loptienm/Door_Control_PCB/README.md

Front Door Controller
=====================

This is a Front Door Dead Bolt Controller.  This board integrates a Particle Core, a motor controller, and the Lockitron Mechanical Assembly from Sparkfun to lock and unlock the deadbolt on an external door over the internet.
