loptienm/Door_Control_PCB/FrontDoorController.brd

## EAGLE design FrontDoorController.brd (2015-07-19)

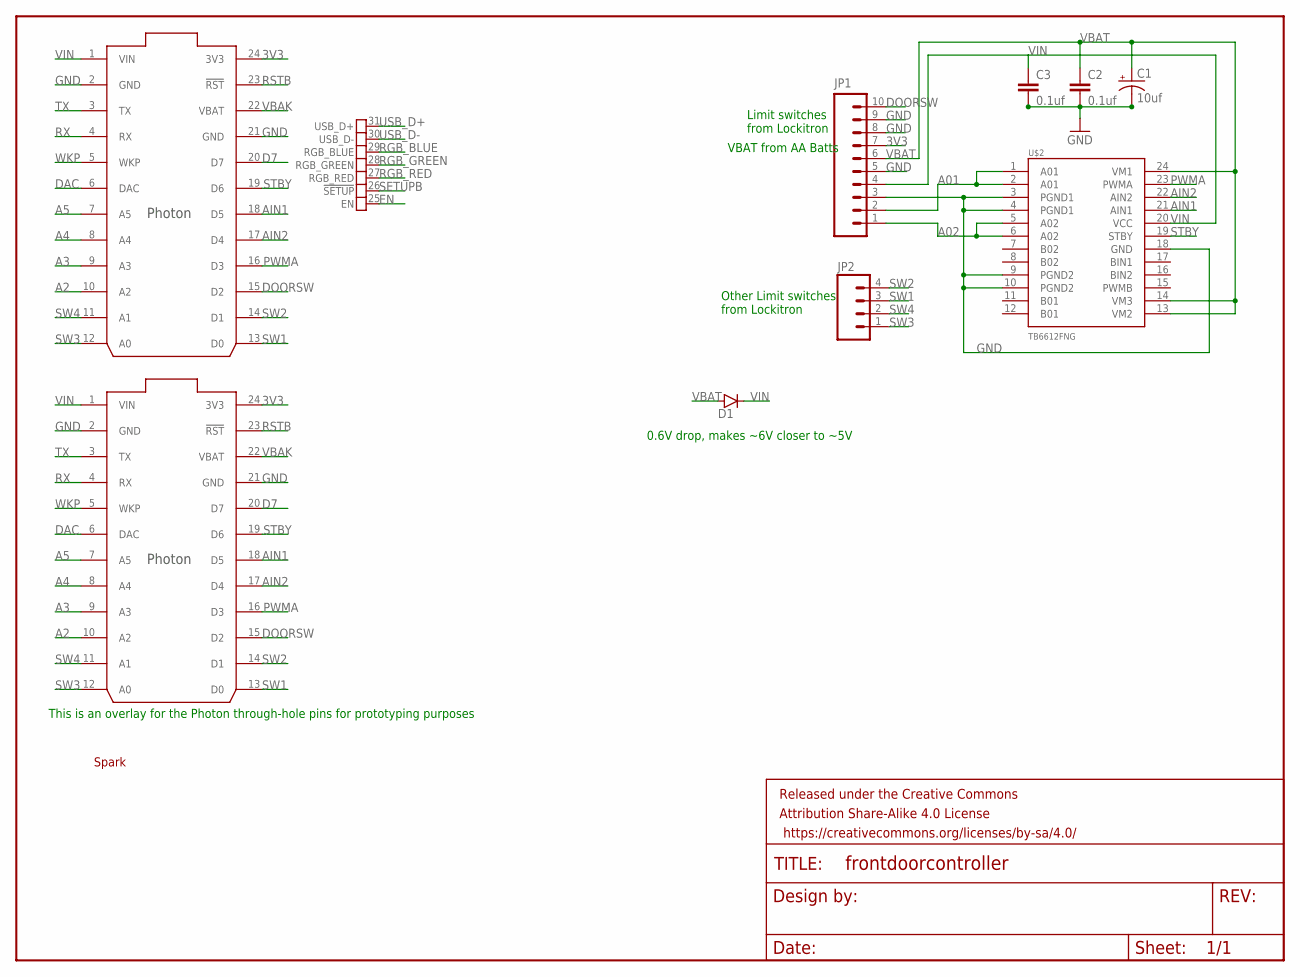
[picture p1: schematic FrontDoorController.sch]

Parts:
C1: 10uf; EIA3528
C2, C3: 0.1uf; 0402-CAP
D1: DIODEPTH; DIODE-1N4001
FRAME1: FRAME-LETTER; CREATIVE_COMMONS
JP1: M10LOCK; 1X10_LOCK
JP2: M04LOCK; 1X04_LOCK
PHOTON: PHOTON_SMD
U$1: SPARK_LOGOLARGE; SPARK_LOGO
U$2: TB6612FNG; SSOP24
U$3: PHOTON_WITH_HEADERS; PHOTON

Connections:
3V3: JP1.7, PHOTON.24 (3V3), U$3.24 (3V3)
A01: JP1.2, U$2.1 (A01), U$2.2 (A01)
A2: PHOTON.10 (A2), U$3.10 (A2)
A02: JP1.1, U$2.5 (A02), U$2.6 (A02)
A3: PHOTON.9 (A3), U$3.9 (A3)
A4: PHOTON.8 (A4), U$3.8 (A4)
A5: PHOTON.7 (A5), U$3.7 (A5)
AIN1: PHOTON.18 (D5), U$2.21 (AIN1), U$3.18 (D5)
AIN2: PHOTON.17 (D4), U$2.22 (AIN2), U$3.17 (D4)
D7: PHOTON.20 (D7), U$3.20 (D7)
DAC: PHOTON.6 (DAC), U$3.6 (DAC)
DOORSW: JP1.10, PHOTON.15 (D2), U$3.15 (D2)
EN: PHOTON.25 (EN)
GND: C1.C (-), C2.2, C3.2, JP1.3, JP1.5, JP1.8, JP1.9, PHOTON.2 (GND), PHOTON.21 (GND), U$2.3 (PGND1), U$2.4 (PGND1), U$2.9 (PGND2), U$2.10 (PGND2), U$2.18 (GND), U$3.2 (GND), U$3.21 (GND)
PWMA: PHOTON.16 (D3), U$2.23 (PWMA), U$3.16 (D3)
RGB_BLUE: PHOTON.29 (RGB_BLUE)
RGB_GREEN: PHOTON.28 (RGB_GREEN)
RGB_RED: PHOTON.27 (RGB_RED)
RSTB: PHOTON.23 (!RST), U$3.23 (!RST)
RX: PHOTON.4 (RX), U$3.4 (RX)
SETUPB: PHOTON.26 (!SETUP)
STBY: PHOTON.19 (D6), U$2.19 (STBY), U$3.19 (D6)
SW1: JP2.3, PHOTON.13 (D0), U$3.13 (D0)
SW2: JP2.4, PHOTON.14 (D1), U$3.14 (D1)
SW3: JP2.1, PHOTON.12 (A0), U$3.12 (A0)
SW4: JP2.2, PHOTON.11 (A1), U$3.11 (A1)
TX: PHOTON.3 (TX), U$3.3 (TX)
USB_D+: PHOTON.31 (USB_D+)
USB_D-: PHOTON.30 (USB_D-)
VBAK: PHOTON.22 (VBAT), U$3.22 (VBAT)
VBAT: C1.A (+), C2.1, D1.A, JP1.6, U$2.13 (VM2), U$2.14 (VM3), U$2.24 (VM1)
VIN: C3.1, D1.C, JP1.4, PHOTON.1 (VIN), U$2.20 (VCC), U$3.1 (VIN)
WKP: PHOTON.5 (WKP), U$3.5 (WKP)

Notes on the sheet:
VBAT from AA Batts
0.6V drop, makes ~6V closer to ~5V
This is an overlay for the Photon through-hole pins for prototyping purposes
Limit switches from Lockitron
Other Limit switches from Lockitron

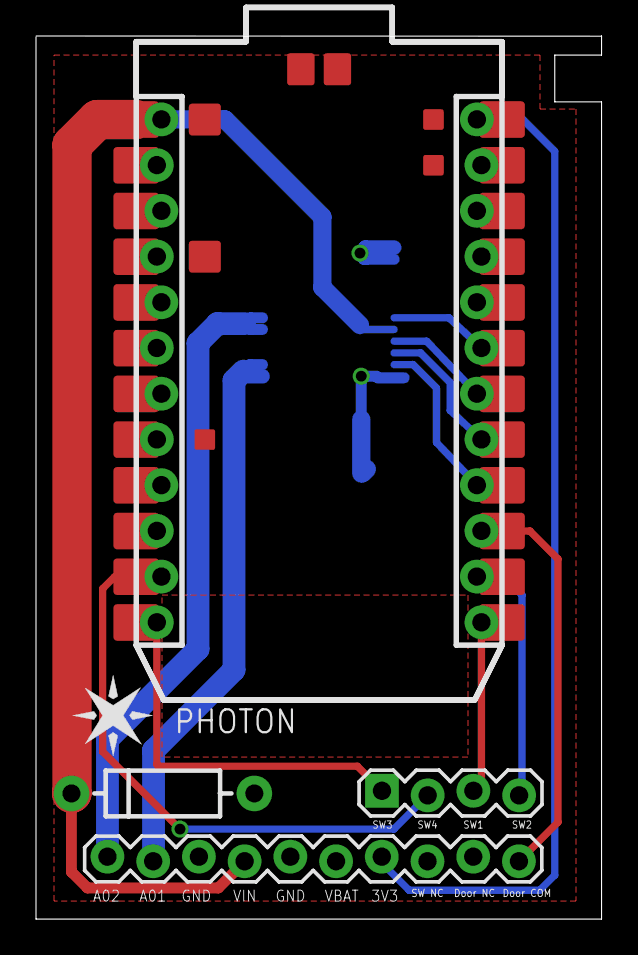
[picture p2: board FrontDoorController.brd from above]

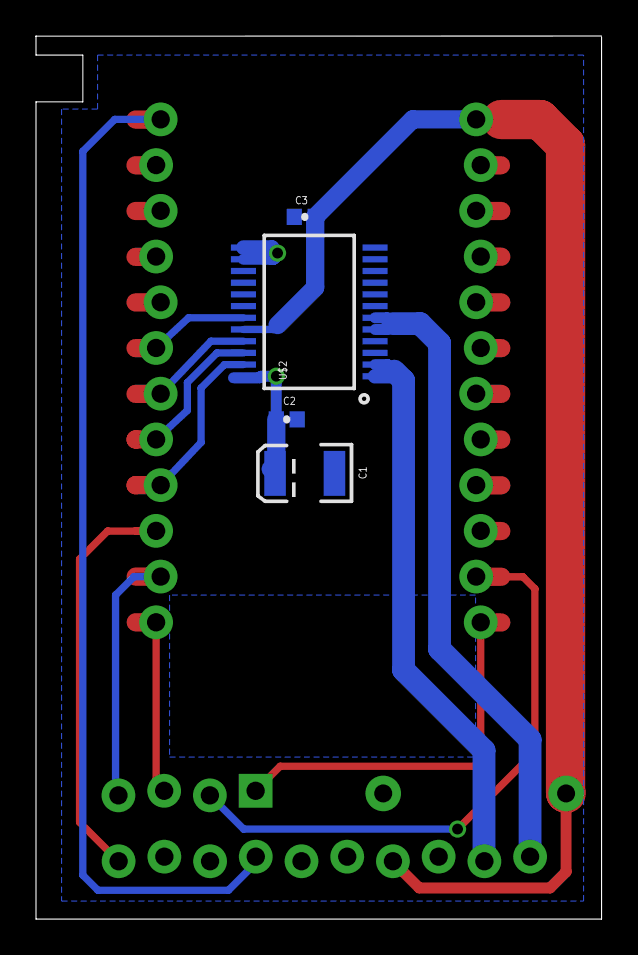
[picture p3: board FrontDoorController.brd from below]

Board: 2 copper layers, 31.4 x 49.1 mm, 11 parts (4 on the bottom side), 26 nets.
