loptienm/Door_Control_PCB/(commit log)

2015-07-10 Door_Control_PCB: Add initial Eagle schematic and board
    Add the initial Eagle schematic and board files. These are currently
    empty.
    [FrontDoorController.brd, FrontDoorController.sch]
2015-07-10 Door_Control_PCB: Move the directory structure around
    Move the directory structure around to make it match the other projects
    I have going on.
    [FrontDoorController.brd, FrontDoorController.sch]
2015-07-10 Door_Control_PCB: Add Photon and define board
    Add the Photon to the schematic and board and define the board outline
    including the holder tab that gets inserted into the mechanical assembly
    to hold the board in place.
2015-07-11 Door_Control_PCB: Add motor driver and connect
    Add the TB6612FNG motor driver and connect it to the Photon. This will
    take power from 4 AA batteries in the Lockitron and drive the Lockitron
    motor. The Photon will control direction and speed for the motor.
    Since there is only 1 motor on the Lockitron, only 1 of the input/output
    pairs on the driver needs to be connected.
    [FrontDoorController.brd, FrontDoorController.sch]
2015-07-11 Door_Control_PCB: Add headers and diode
    Exchange the screw terminals for 0.1" breakaway header holes. There is
    no room for the screw terminals in the Lockitron so wires will need to
    be soldered directly to the board. Some space can be saved by using
    0.1" spacing header holes instead of the bigger pitch screw terminals.
    Also do a few other minor cleanup tasks like change the size of the wire
    input labels. Also add a 1N4001 diode between VM from AA's and VIN on
    Photon to drop the voltage from about 6V to about 5V to ensure it is
    safe for the Photon VIN input.
    [FrontDoorController.brd, FrontDoorController.sch]
2015-07-11 Door_Control_PCB: Add Photon through holes
    Add in an additional part for the Photon through-hole connections. This
    can be used to attach the Photon to the board without soldering it down.
    Also reconnect the wires to the new Photon holes and clean up the
    schematic a bit.
    [FrontDoorController.brd, FrontDoorController.sch]
2015-07-11 Door_Control_PCB: Shrink the board a bit to save money
    The board did not need to be nearly as big as it was and shrinking it a
    bit can save some money in maunfacturing.
    [FrontDoorController.brd]
2015-07-11 Door_Control_PCB: Add more header pins
    Add more header pins to be able to measure all voltages, and connect to
    the limit switches on the Lockitron to log the deadbolt position. Also
    reroute the motor drive wires to not go through the Photon through hole
    pins and make the wires larger to drive more current.
    [FrontDoorController.brd, FrontDoorController.sch]
2015-07-16 Door_Control_PCB: Add reed switch connection
    Add a connection point for a reed switch to be used to sense if the door
    is open or closed. Also add a pull down resistor to ensure good
    readings and label the pins on the header.
    [FrontDoorController.brd, FrontDoorController.sch]
2015-07-16 Door_Control_PCB: Change layer of labels
    Change the layer of the header labels because they didn't show up on Osh
    Park.
    [FrontDoorController.brd, FrontDoorController.sch]
2015-07-16 Door_Control_PCB: Make the cutout a bit bigger
    Make the cutout and tab for the slot that holds onto the Lockitron
    mechanical assembly a bit bigger so that the fab will (hopefully) make
    it. The pictures from Sparkfun show this tab as being about 1/20th of
    an inch or about 0.05 inches (about 50 mils).
    [FrontDoorController.brd]
2015-07-16 Door_Control_PCB: Change layer of measurements
    Change the layer that the measurements appeared on because they are now
    showing up on Osh Park.
    [FrontDoorController.brd]
2015-07-16 Door_Control_PCB: Add Particle Logo
    Add the Particle (Spark) logo to the board to make it cooler looking and
    more official (not at all official).
    [FrontDoorController.brd, FrontDoorController.sch]
2015-07-19 Door_Control_PCB: Add locking Photon and reroute
    Add the locking Photon from Mike's Library so that I can try out the
    connections before soldering. Also reroute some things and make a few
    traces bigger and move some of the header pins around.
    [FrontDoorController.sch]
2015-07-19 Door_Control_PCB: Add SW3 and SW4 from Lockitron
    The Lockitron has 4 limit switches instead of 2 like I originally
    thought. They also need a common place to wire their NC connections to
    and with this many switches it seemed best to give them their own header
    row, causing some other components to have to move and some other pins
    to need moving as well. Things all seem to flow well now and there
    should be plenty of power to all of the components.
    [FrontDoorController.brd, FrontDoorController.sch]
2015-07-19 Door_Control_PCB: Widen Motor A01/2 traces
    These were probably wide enough but I thought that giving them as much
    surface area as possible to transmit high current to the motor is a good
    thing so I widened the traces by a bit. This also made the connections
    to the IC pads much prettier.
    [FrontDoorController.brd]
